AndyFHWN/CLIMB_PSU/PSU_Pinout_V3.pdf

## GND

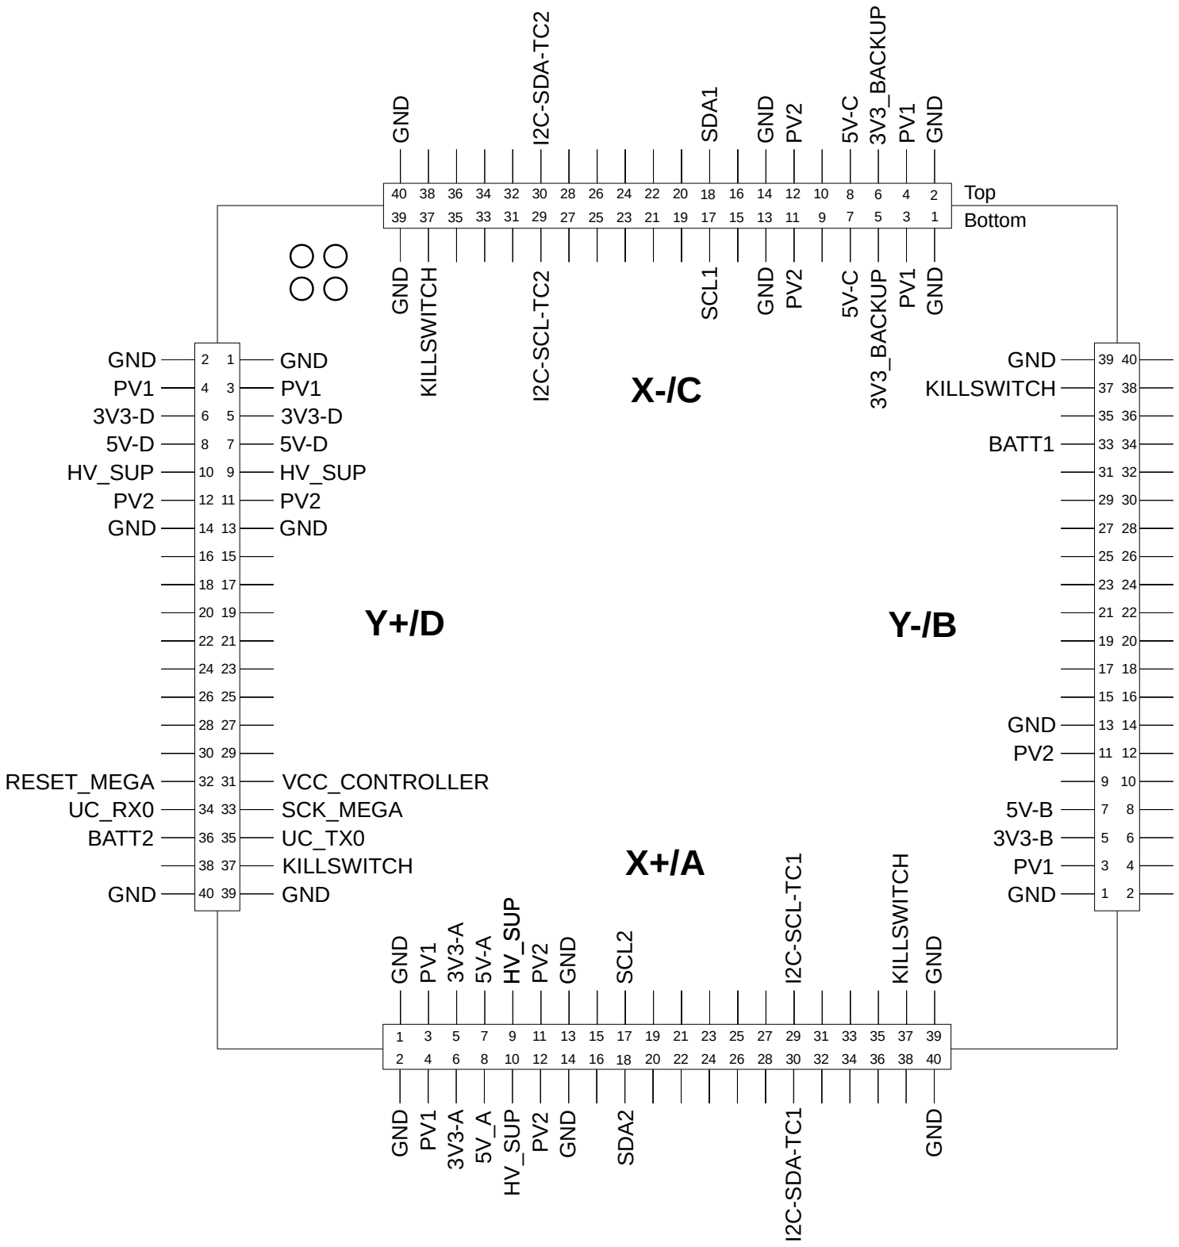
[picture p7: figure]
GND KILLSWITCH; BATT1; GND PV2; 5V-B 3V3-B PV1 GND; KIL; WIT; GND; RESET_MEGA; HV_SUP; VCC_CONTROLLER; SCK_MEGA; BATT2; KILLSWITCH; Bottom; Top

## GND

PV2

5V-B
3V3-B
PV1

## GND
