AndyFHWN/CLIMB_PSU/EPS_CC2/EPS_CC2/io.h

/*
 * io.h
 *
 *  Created on: 9 Feb 2015
 *      Author: Wolfgang Lubowski
 */

#ifndef IO_H_
#define IO_H_

	//INCLUDES
	#include <avr/io.h>
	#include "main.h"

	//DEFINITIONS


	//VARIABLES

	//FUNCTION PROTOTYPES
	void io_init();
	void set_outputs();

#endif /* IO_H_ */
