AndyFHWN/CLIMB_PSU/EPS_CC2/EPS_CC2/powerup.h

/*
 * powerup.h
 *
 *  Created on: 9 Feb 2015
 *      Author: Wolfgang Lubowski
 */

#ifndef POWERUP_H_
	#define POWERUP_H_

	//INCLUDES
	#include <avr/sleep.h>
	#include "io.h"
	#include "main.h"

	//DEFINITIONS

	//VARIABLES

	//FUNCTION PROTOTYPES
	void powerup();
	void boot_ct();

#endif /* POWERUP_H_ */
